3bdulr7manel-maker/F1Tenth-Semi-Autonomous-Vehicle-Platform/Schematic.pdf

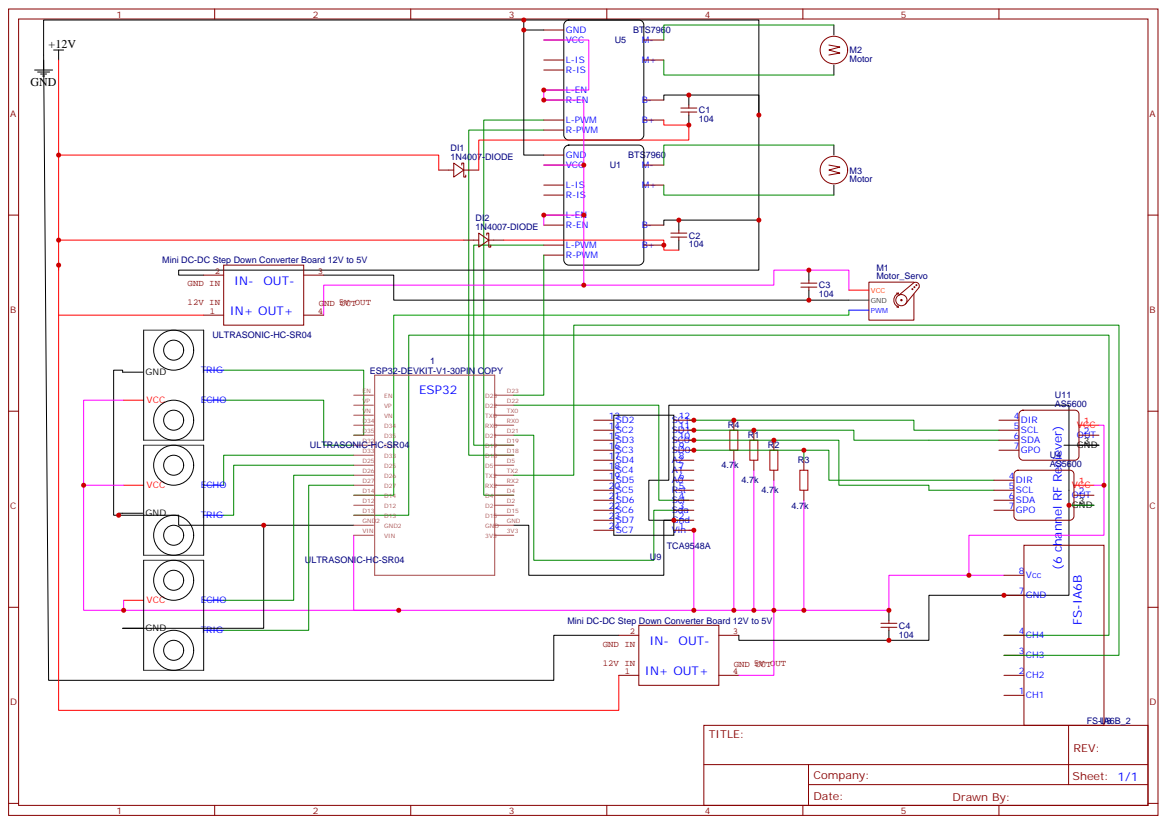
[picture p21: page 1]

Mini DC-DC Step Down Converter Board 12V to 5V

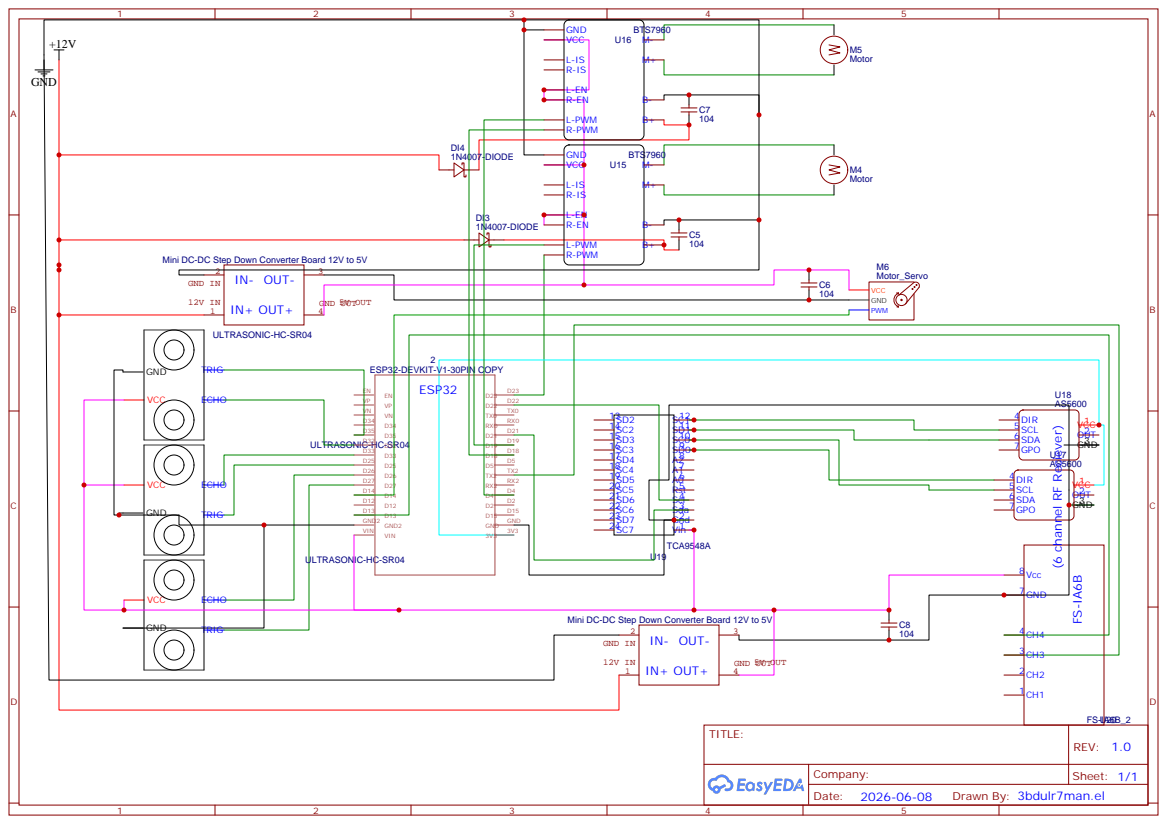
[picture p22: page 2]

Mini DC-DC Step Down Converter Board 12V to 5V
