3bdulr7manel-maker/F1Tenth-Semi-Autonomous-Vehicle-Platform/PCB.pdf

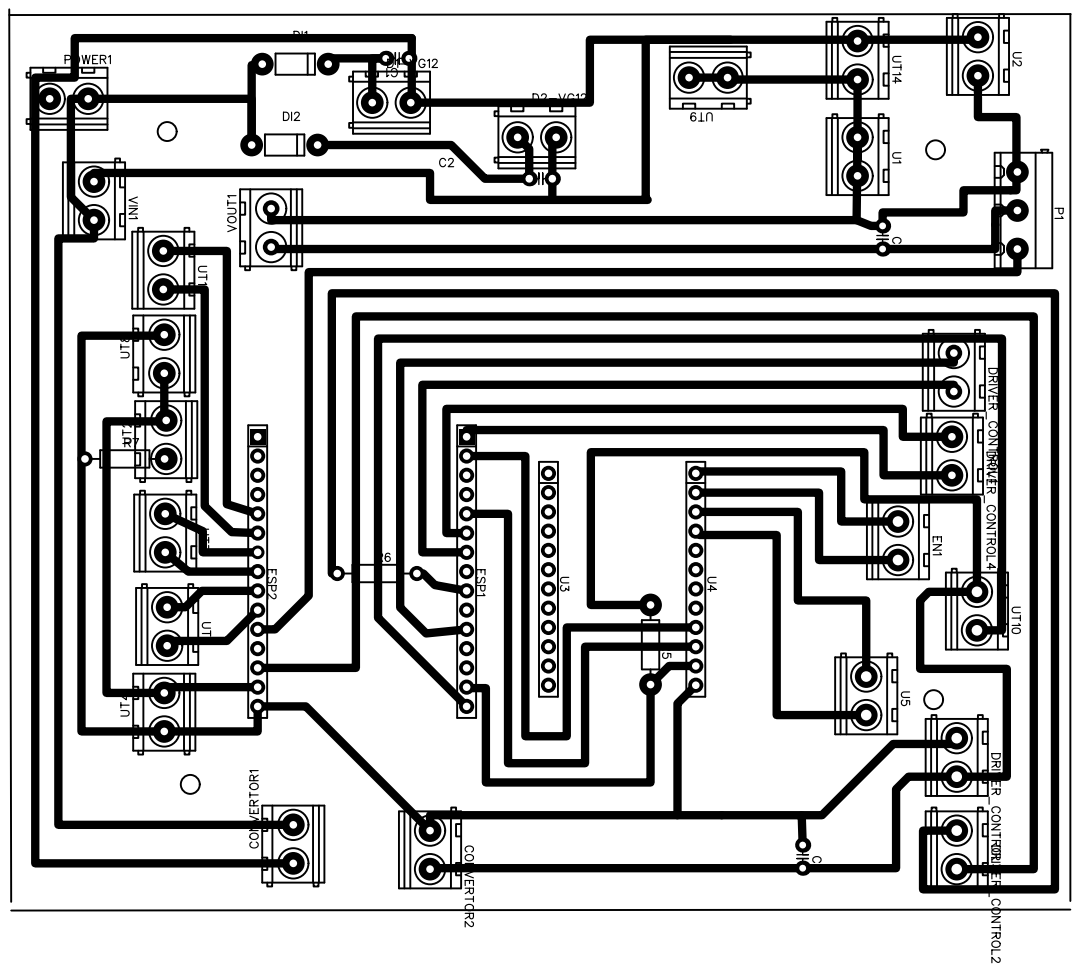
[picture p23: page 1]
